bqlabs/miniBLIP/README.md

# miniBLIP
### miniBLIP
Prototyping Board developed together with @Victornomad for @Circolab friends.

A new way of approaching electronics, complete and cost effective!

### License
This project is licensed under [CC-BY-SA](http://creativecommons.org/licenses/by-sa/3.0/es/)
