bqlabs/miniBLIP/doc/main.png

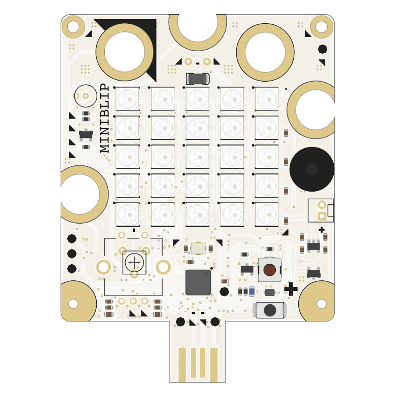
doc/main.png
