bqlabs/miniBLIP/miniBLIPloader/bin.xojo_binary_project/Linux/miniblip/Resources/miniblip.png

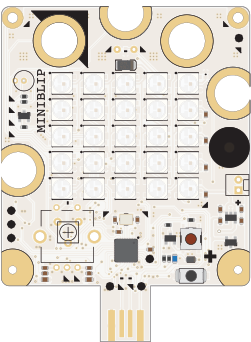
miniBLIPloader/bin.xojo_binary_project/Linux/miniblip/Resources/miniblip.png
