bqlabs/miniBLIP/(list of files, cad)

Other CAD files:
3D/Alfa.skp
