bqlabs/miniBLIP/Silk/Studio Banana/board_circolab 8.pdf

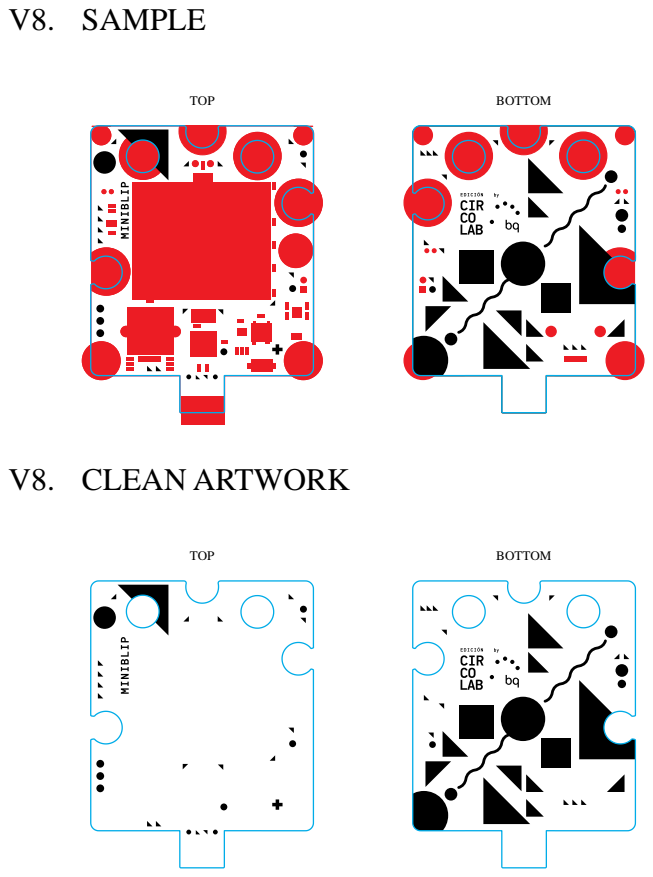
[picture p3: page 1]
V8. SAMPLE; TOP; BOTTOM; V8. CLEAN ARTWORK
