bqlabs/miniBLIP/miniBLIPloader/miniblip.pdf

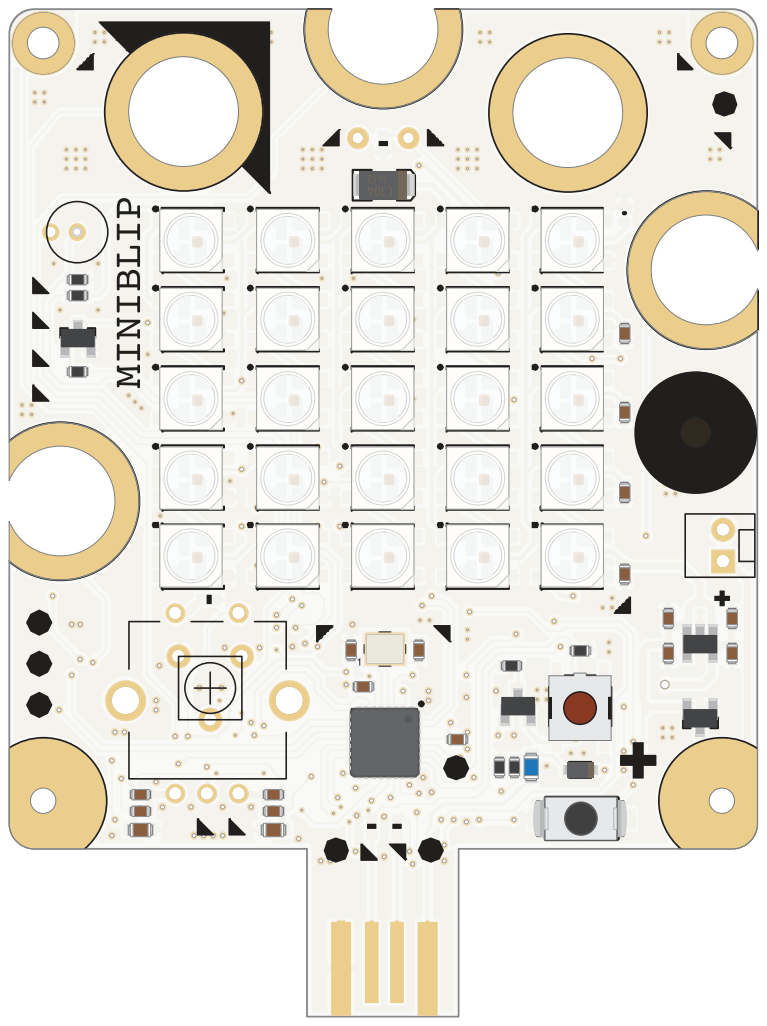
[picture p4: page 1]
