bqlabs/miniBLIP/Silk/Studio Banana/AAFF_V8_BOARD_CIRCOLAB.pdf

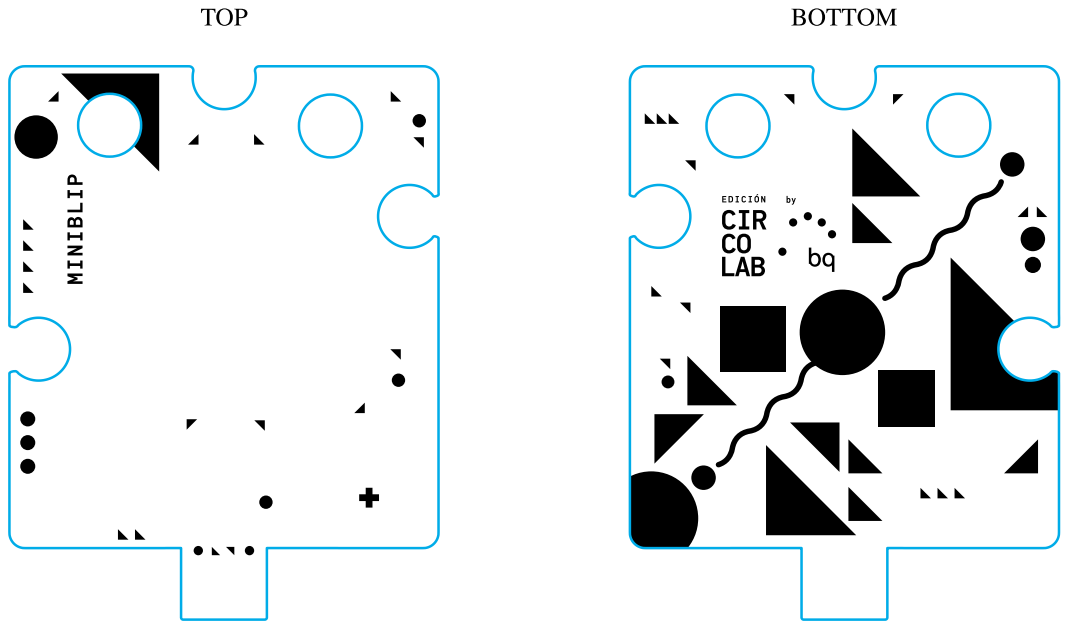
[picture p5: page 1]
