bqlabs/miniBLIP/Silk_r2/bqcreative_v2.brd

## EAGLE design Silk_r2/bqcreative_v2.brd (2015-11-03)

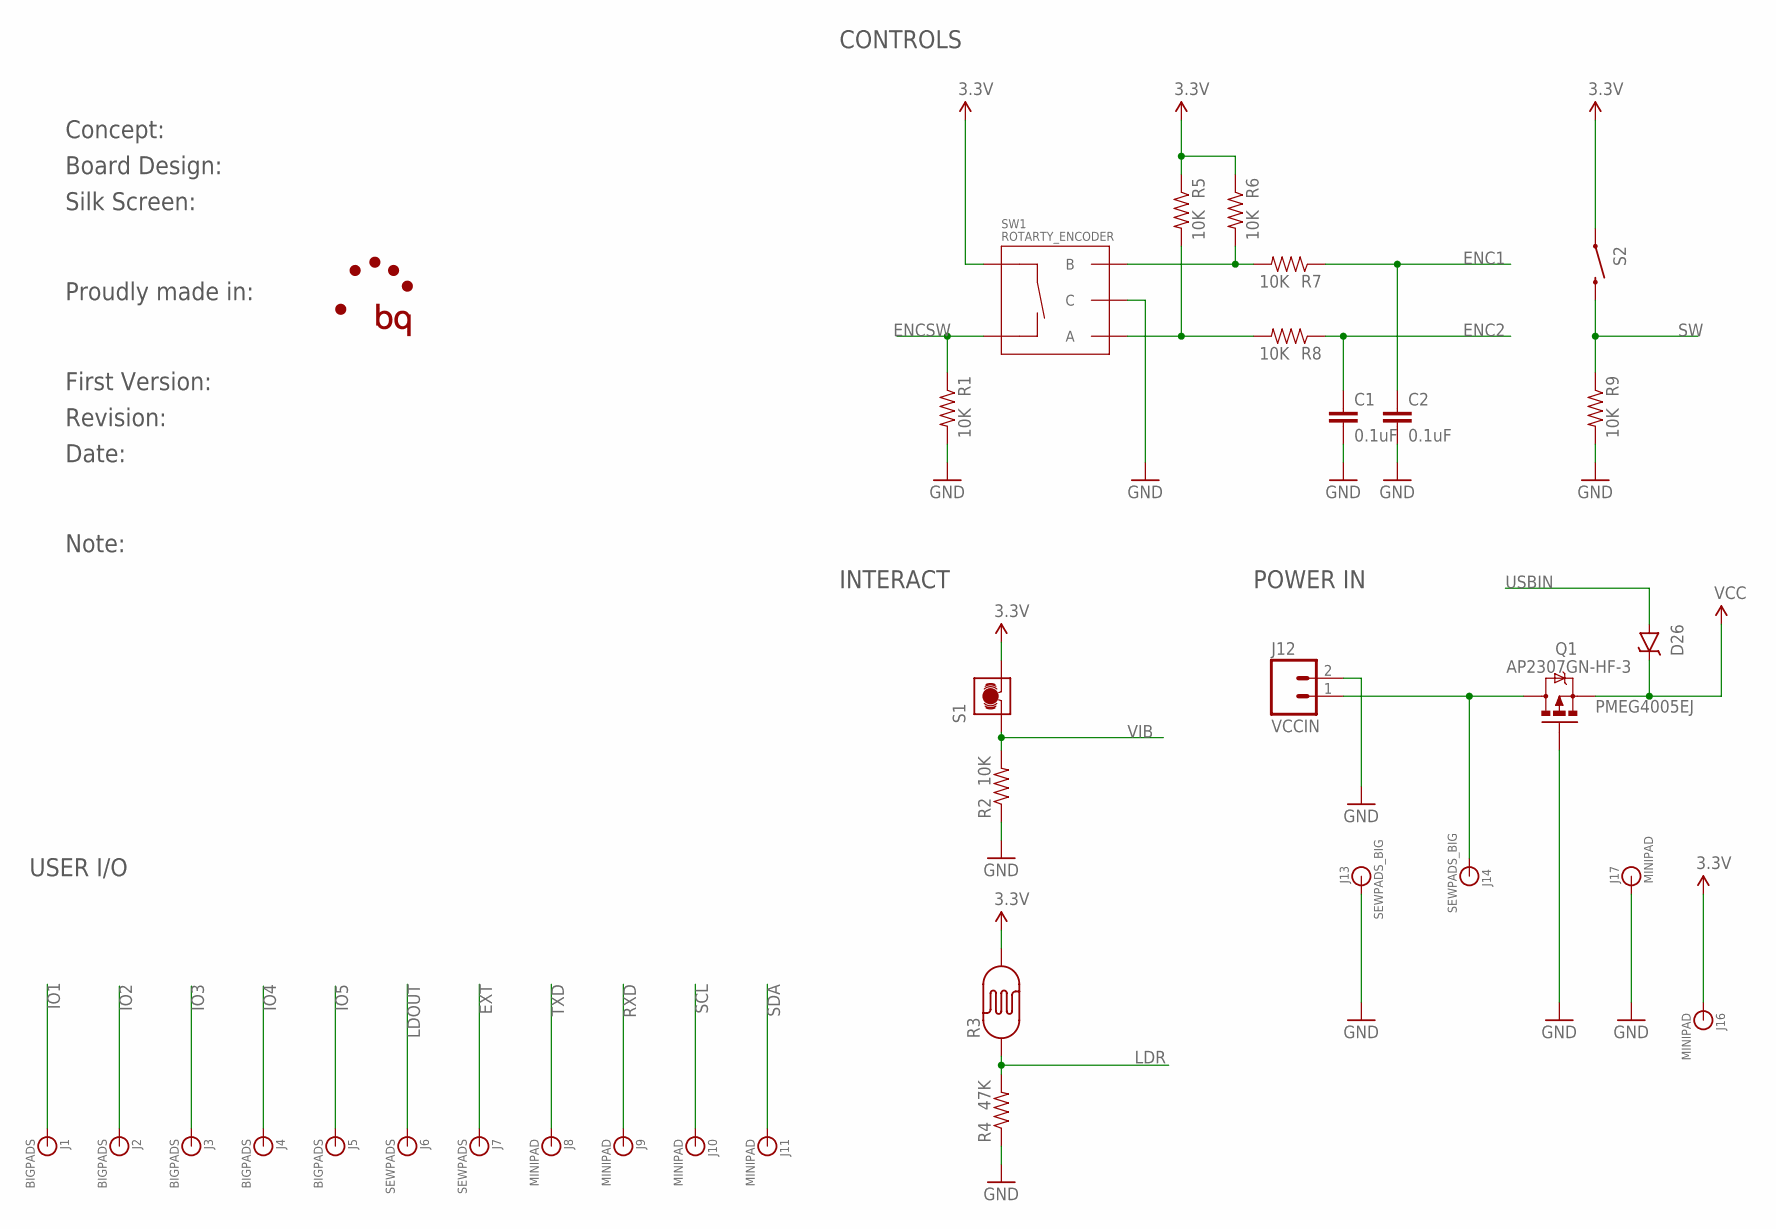
[picture p6: schematic bqcreative_v2.sch, sheet 1]

Parts:
C1, C2: 0.1uF; 0603-CAP
D26: PMEG4005EJ; SOD-323
J1, J2, J3, J4, J5: BIGPADS; BIGPAD
J6, J7: SEWPADS; SEWPAD
J8, J9, J10, J11, J16, J17: MINIPAD
J12: VCCIN; MOLEX-1X2
J13, J14: SEWPADS_BIG; SEWPAD_BIG
Q1: AP2307GN-HF-3; SOT23-3
R1, R2, R5, R6, R7, R8, R9: 10K; 0402-RES
R3: PHOTOCELLPTH; PHOTOCELL
R4: 47K; 0402-RES
S1: VIBRATION-SWITCH
S2: SWITCH-MOMENTARY-2SMD; TACTILE-SWITCH-SMD
SW1: ROTARTY_ENCODER; ROTARY_ENC_PLAIN

Connections:
3.3V: J16.P$1, J16.P$2, R3.2, R5.1, R6.1, S1.2, S2.1, SW1.SW+; also elsewhere on the board
ENC1: C2.1, R7.1; also elsewhere on the board
ENC2: C1.1, R8.1; also elsewhere on the board
ENCSW: R1.1, SW1.SW-; also elsewhere on the board
EXT: J7.P$1; also elsewhere on the board
GND: C1.2, C2.2, J12.2, J13.P$1, J17.P$1, J17.P$2, Q1.1 (G), R1.2, R2.1, R4.1, R9.2, SW1.C; also elsewhere on the board
IO1: J1.P$1; also elsewhere on the board
IO2: J2.P$1; also elsewhere on the board
IO3: J3.P$1; also elsewhere on the board
IO4: J4.P$1; also elsewhere on the board
IO5: J5.P$1; also elsewhere on the board
LDOUT: J6.P$1; also elsewhere on the board
LDR: R3.1, R4.2; also elsewhere on the board
unnamed: J12.1, J14.P$1, Q1.3 (D)
unnamed: R6.2, R7.2, SW1.B
unnamed: R5.2, R8.2, SW1.A
RXD: J9.P$1, J9.P$2; also elsewhere on the board
SCL: J10.P$1, J10.P$2; also elsewhere on the board
SDA: J11.P$1, J11.P$2; also elsewhere on the board
SW: R9.1, S2.3 (2); also elsewhere on the board
TXD: J8.P$1, J8.P$2; also elsewhere on the board
USBIN: D26.A; also elsewhere on the board
VCC: D26.C, Q1.2 (S); also elsewhere on the board
VIB: R2.2, S1.1; also elsewhere on the board

Notes on the sheet:
CONTROLS
USER I/O
INTERACT
POWER IN
Concept:
Board Design:
Silk Screen:
Proudly made in:
First Version:
Revision:
Date:
Note:

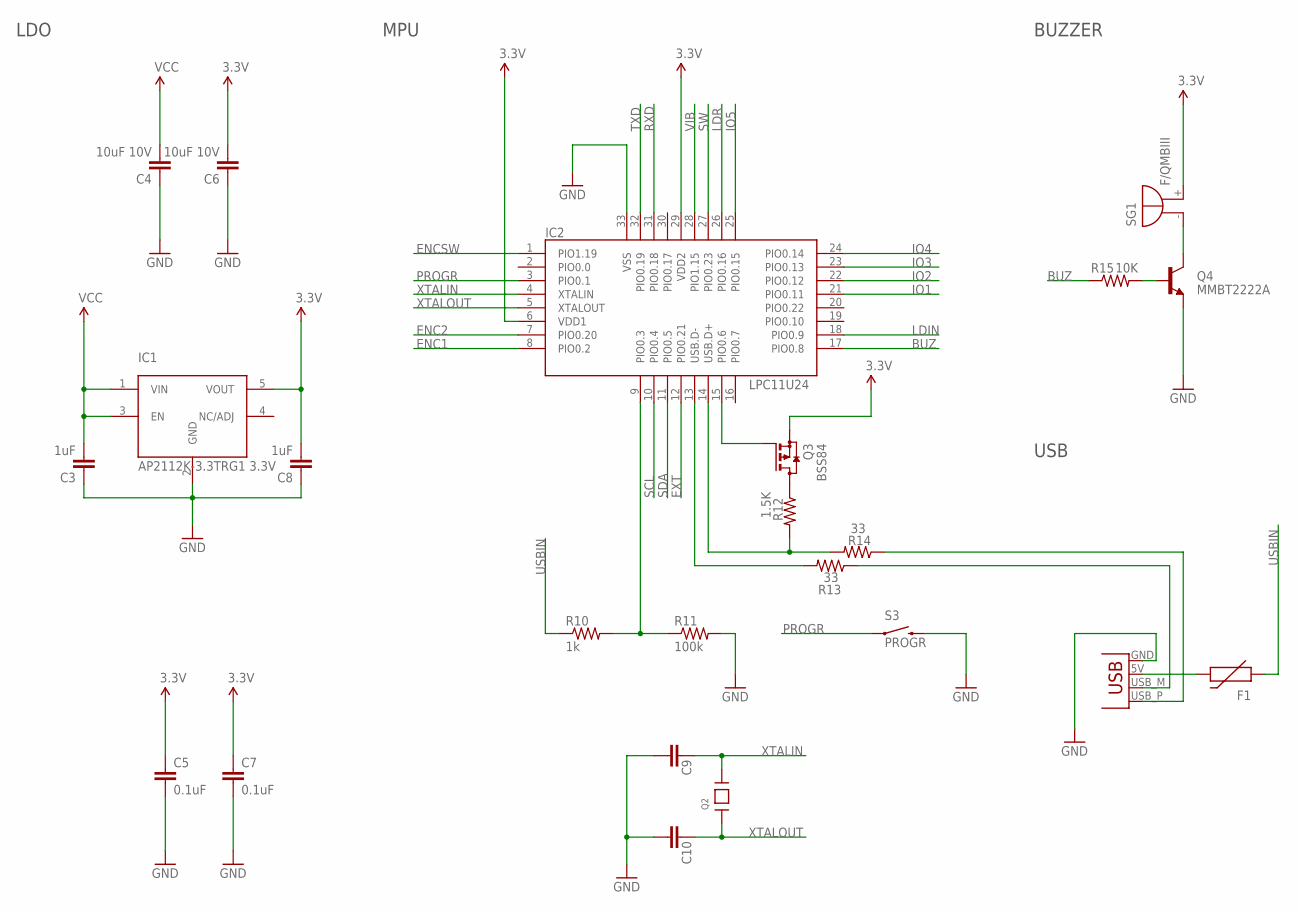
[picture p7: schematic bqcreative_v2.sch, sheet 2]

Parts:
C3, C8: 1uF; 0402-CAP
C4, C6: 10uF 10V; 0402-CAP
C5, C7: 0.1uF; 0402-CAP
C9, C10: 27pF; 0402-CAP
F1: PTC0603; 0603
IC1: AP2112K-3.3TRG1 3.3V; SOT23-5
IC2: LPC11U24; HVQFN33_5X5MM
J15: USBPCB; USB-A-PCB
Q2: 12MHz 4 pad crystal 3.2x2.5; CRYSTAL_3.2X2.5
Q3: BSS84; SOT23
Q4: MMBT2222A; SOT23-3
R10: 1k; 0402-RES
R11: 100k; 0402-RES
R12: 1.5K; 0402-RES
R13, R14: 33; 0402-RES
R15: 10K; 0402-RES
S3: PROGR; TACTILE-SWITCH-1101NE
SG1: F/QMBIII

Connections:
3.3V: C5.1, C6.2, C7.1, C8.2, IC1.5 (VOUT), IC2.6 (VDD1), IC2.29 (VDD2), Q3.2 (S), SG1.+ (-); also elsewhere on the board
BUZ: IC2.17 (PIO0.8), R15.1
ENC1: IC2.8 (PIO0.2); also elsewhere on the board
ENC2: IC2.7 (PIO0.20); also elsewhere on the board
ENCSW: IC2.1 (PIO1.19); also elsewhere on the board
EXT: IC2.12 (PIO0.21); also elsewhere on the board
GND: C3.1, C4.1, C5.2, C6.1, C7.2, C8.1, C9.2, C10.2, IC1.2 (GND), IC2.33 (VSS), J15.GND, Q4.2 (E), R11.2, S3.2; also elsewhere on the board
IO1: IC2.21 (PIO0.11); also elsewhere on the board
IO2: IC2.22 (PIO0.12); also elsewhere on the board
IO3: IC2.23 (PIO0.13); also elsewhere on the board
IO4: IC2.24 (PIO0.14); also elsewhere on the board
IO5: IC2.25 (PIO0.15); also elsewhere on the board
LDIN: IC2.18 (PIO0.9); also elsewhere on the board
LDR: IC2.26 (PIO0.16); also elsewhere on the board
unnamed: Q4.3 (C), SG1.- (+)
unnamed: Q4.1 (B), R15.2
unnamed: J15.USB_P (D+), R14.1
unnamed: F1.2, J15.5V (VBUS)
unnamed: J15.USB_M (D-), R13.1
unnamed: IC2.14 (USB.D+), R12.2, R14.2
unnamed: IC2.13 (USB.D-), R13.2
unnamed: Q3.3 (D), R12.1
unnamed: IC2.15 (PIO0.6), Q3.1 (G)
P0.3/ISP_COMMAND_USB_HIGH: IC2.9 (PIO0.3), R10.2, R11.1
PROGR: IC2.3 (PIO0.1), S3.1
RXD: IC2.31 (PIO0.18); also elsewhere on the board
SCL: IC2.10 (PIO0.4); also elsewhere on the board
SDA: IC2.11 (PIO0.5); also elsewhere on the board
SW: IC2.27 (PIO0.23); also elsewhere on the board
TXD: IC2.32 (PIO0.19); also elsewhere on the board
USBIN: F1.1, R10.1; also elsewhere on the board
VCC: C3.2, C4.2, IC1.1 (VIN), IC1.3 (EN); also elsewhere on the board
VIB: IC2.28 (PIO1.15); also elsewhere on the board
XTALIN: C9.1, IC2.4 (XTALIN), Q2.3
XTALOUT: C10.1, IC2.5 (XTALOUT), Q2.1

Notes on the sheet:
LDO
MPU
BUZZER
USB

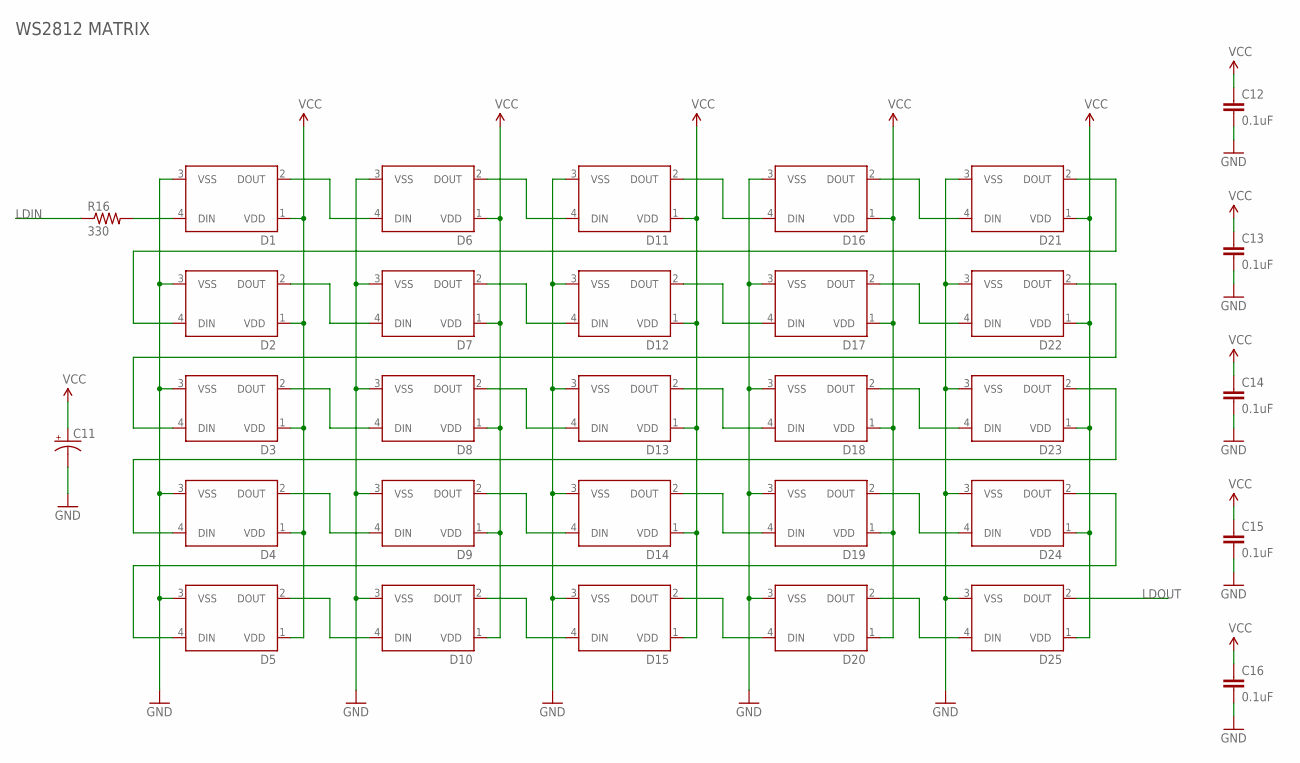
[picture p8: schematic bqcreative_v2.sch, sheet 3]

Parts:
C11: CAP_POL1206; EIA3216
C12, C13, C14, C15, C16: 0.1uF; 0402-CAP
D1, D2, D3, D4, D5, D6, D7, D8, D9, D10, D11, D12, D13, D14, D15, D16, D17, D18, D19, D20, D21, D22, D23, D24, D25: WS2812B
R16: 330; 0402-RES

Connections:
GND: C11.C (-), C12.2, C13.2, C14.2, C15.2, C16.2, D1.3 (VSS), D2.3 (VSS), D3.3 (VSS), D4.3 (VSS), D5.3 (VSS), D6.3 (VSS), D7.3 (VSS), D8.3 (VSS), D9.3 (VSS), D10.3 (VSS), D11.3 (VSS), D12.3 (VSS), D13.3 (VSS), D14.3 (VSS), D15.3 (VSS), D16.3 (VSS), D17.3 (VSS), D18.3 (VSS), D19.3 (VSS), D20.3 (VSS), D21.3 (VSS), D22.3 (VSS), D23.3 (VSS), D24.3 (VSS), D25.3 (VSS); also elsewhere on the board
LDIN: R16.1; also elsewhere on the board
LDOUT: D25.2 (DOUT); also elsewhere on the board
unnamed: D1.4 (DIN), R16.2
unnamed: D1.2 (DOUT), D6.4 (DIN)
unnamed: D6.2 (DOUT), D11.4 (DIN)
unnamed: D11.2 (DOUT), D16.4 (DIN)
unnamed: D16.2 (DOUT), D21.4 (DIN)
unnamed: D2.2 (DOUT), D7.4 (DIN)
unnamed: D7.2 (DOUT), D12.4 (DIN)
unnamed: D12.2 (DOUT), D17.4 (DIN)
unnamed: D17.2 (DOUT), D22.4 (DIN)
unnamed: D3.2 (DOUT), D8.4 (DIN)
unnamed: D8.2 (DOUT), D13.4 (DIN)
unnamed: D13.2 (DOUT), D18.4 (DIN)
unnamed: D18.2 (DOUT), D23.4 (DIN)
unnamed: D4.2 (DOUT), D9.4 (DIN)
unnamed: D9.2 (DOUT), D14.4 (DIN)
unnamed: D14.2 (DOUT), D19.4 (DIN)
unnamed: D19.2 (DOUT), D24.4 (DIN)
unnamed: D5.2 (DOUT), D10.4 (DIN)
unnamed: D10.2 (DOUT), D15.4 (DIN)
unnamed: D15.2 (DOUT), D20.4 (DIN)
unnamed: D20.2 (DOUT), D25.4 (DIN)
unnamed: D2.4 (DIN), D21.2 (DOUT)
unnamed: D3.4 (DIN), D22.2 (DOUT)
unnamed: D4.4 (DIN), D23.2 (DOUT)
unnamed: D5.4 (DIN), D24.2 (DOUT)
VCC: C11.A (+), C12.1, C13.1, C14.1, C15.1, C16.1, D1.1 (VDD), D2.1 (VDD), D3.1 (VDD), D4.1 (VDD), D5.1 (VDD), D6.1 (VDD), D7.1 (VDD), D8.1 (VDD), D9.1 (VDD), D10.1 (VDD), D11.1 (VDD), D12.1 (VDD), D13.1 (VDD), D14.1 (VDD), D15.1 (VDD), D16.1 (VDD), D17.1 (VDD), D18.1 (VDD), D19.1 (VDD), D20.1 (VDD), D21.1 (VDD), D22.1 (VDD), D23.1 (VDD), D24.1 (VDD), D25.1 (VDD); also elsewhere on the board

Notes on the sheet:
WS2812 MATRIX

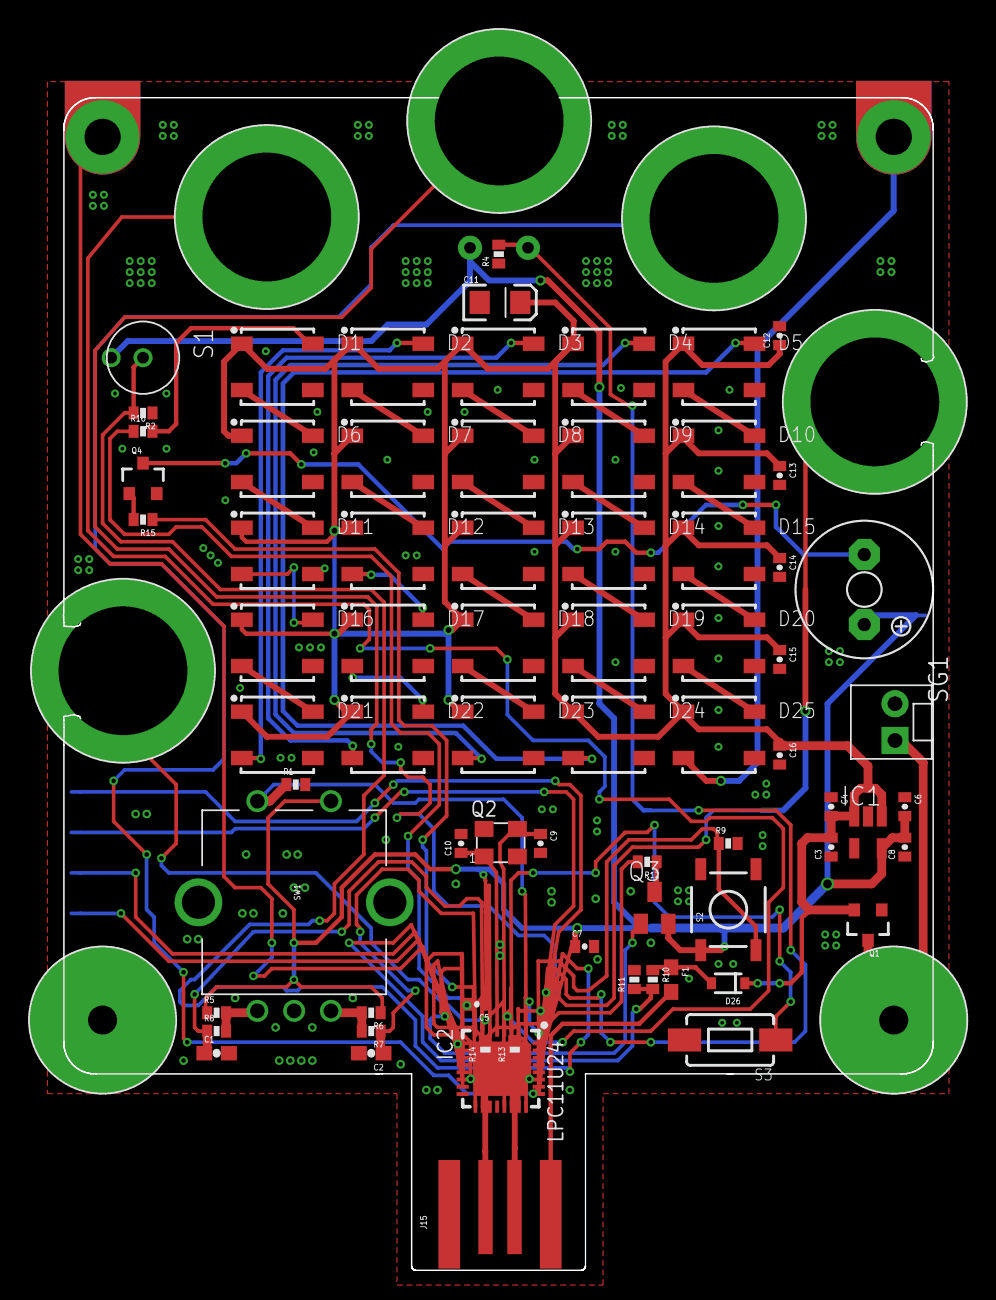
[picture p9: board bqcreative_v2.brd from above]

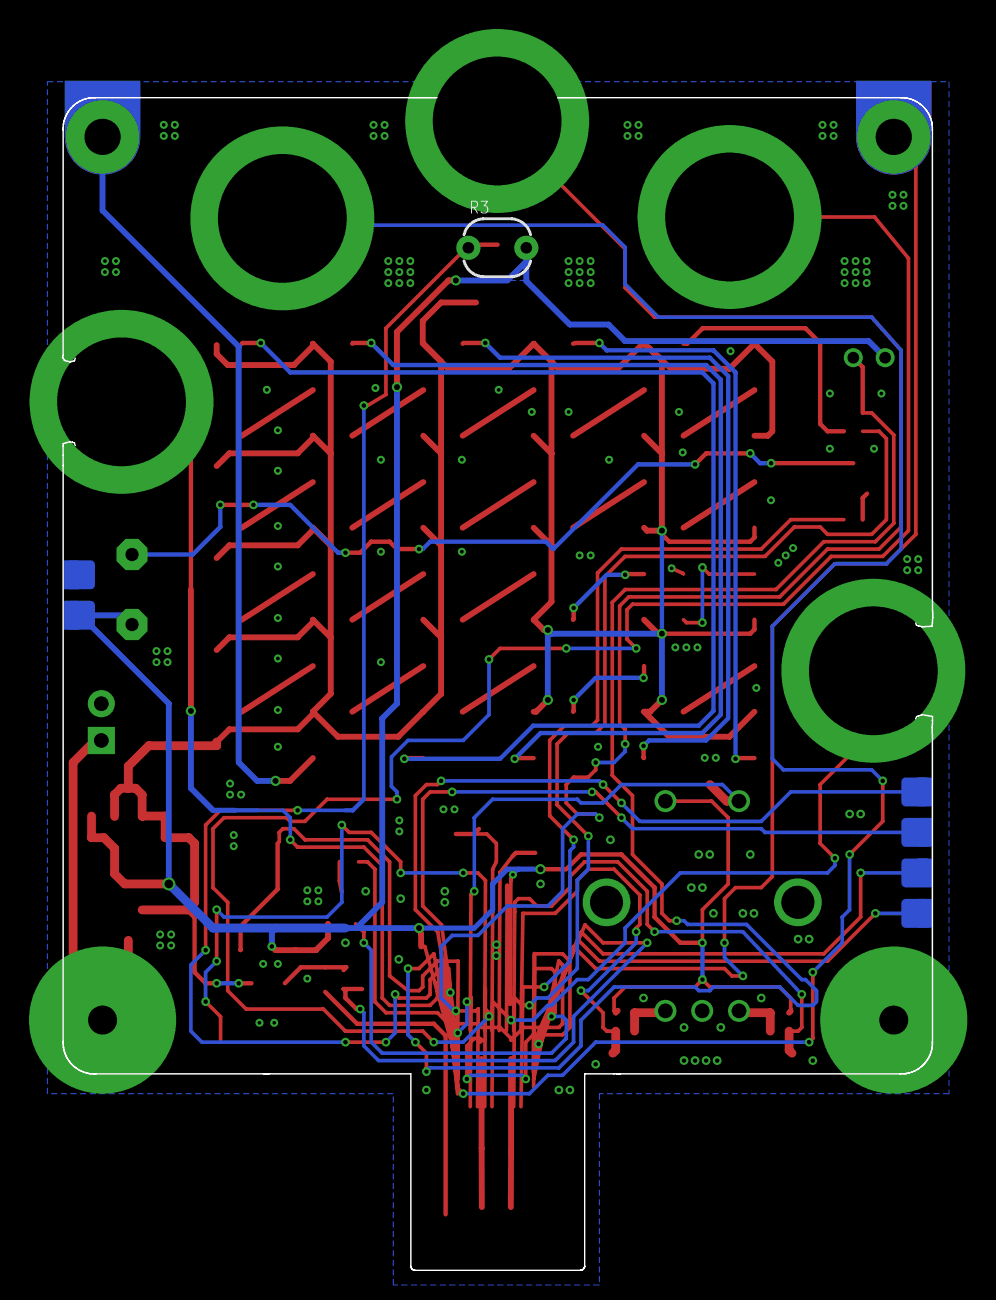
[picture p10: board bqcreative_v2.brd from below]

Board: 2 copper layers, 60.1 x 80.9 mm, 89 parts (7 on the bottom side), 64 nets.

Other parts of the board:
U$1: CIRCOLAB_LOGO
U$2: CIRCOLAB_BQ_LOGO
