bqlabs/miniBLIP/FirmwareTest/How_To_Do.pdf

### How to test the mini blip board

- Plug into the usb port the board with the button S3 pressed (The lower one)
- Once connected release the button
- The board is recognized as a USB drive (Usually named CRP_DISABLED)
- Delete the firmware.bin in the target board
- Copy the new firmware.bin in the target board
- Unmount the board

Result:

- The array of LEDs will start a test and the buzzer play notes
